GuillemCabo/badge_drac/hardware/kicad/drac_badge.kicad_pcb

## KiCad design hardware/kicad/drac_badge.kicad_pcb (2019-09-20)

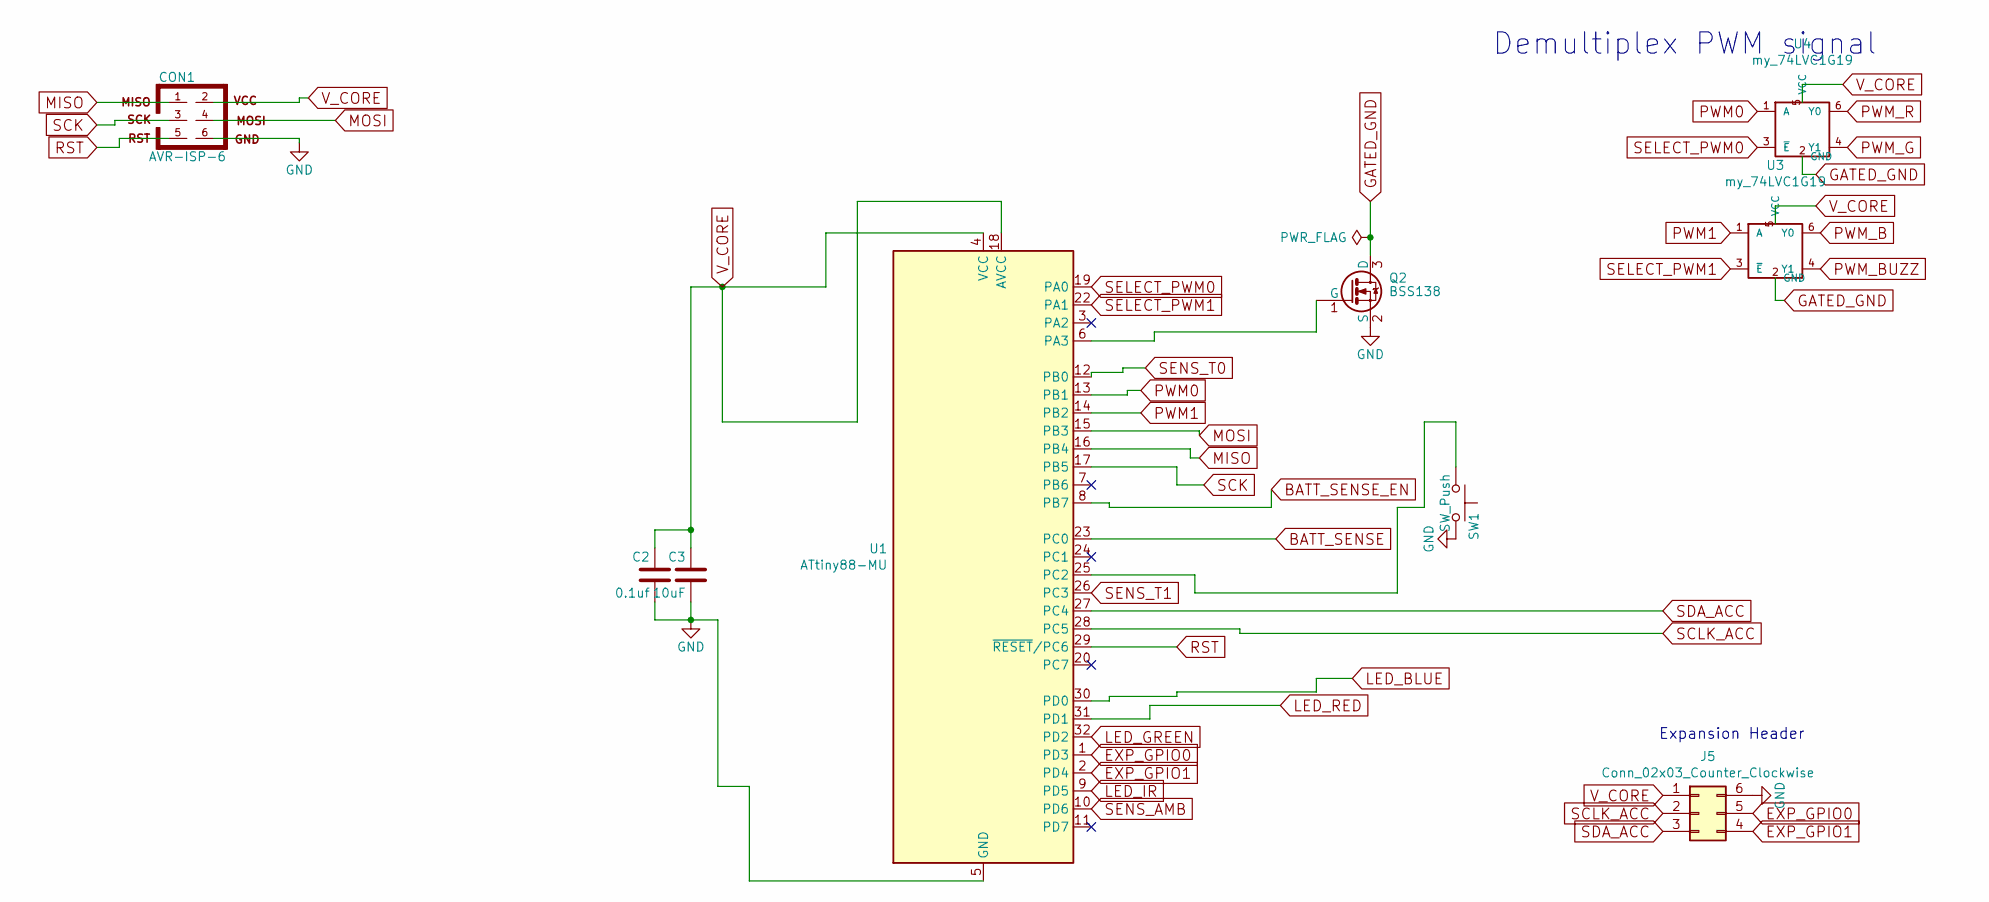
[picture p1: schematic MCU_ATTINY88.sch, keysafe]

Parts:
C2: 0.1uf; C_0603_1608Metric; MPN C0603C104J5RACTU; FARNELL # 2409037
C3: 10uF; C_0805_2012Metric; MPN C0805X106K9RACTU; FARNELL # 2776900
CON1: AVR-ISP-6; MERGED_TAGCONNECT_2.54mm; MPN NONE; FARNELL # NONE
J5: Conn_02x03_Counter_Clockwise; PinSocket_2x03_P2.54mm_Vertical_SMD
Q2: BSS138; SOT-23; MPN BSS138PW; FARNELL # 1907611
SW1: SW_Push; SW_Push_1P1T_NO_CK_KSC7xxJ; MPN EVQPUK02K; FARNELL # 2079467
U1: ATtiny88-MU; QFN-32-1EP_5x5mm_P0.5mm_EP3.1x3.1mm; MPN ATTINY88-MU; FARNELL # 1748549
U3, U4: my_74LVC1G19; SOT-363_SC-70-6

Connections:
BATT_SENSE: U1.23 (PC0); also elsewhere on the board
BATT_SENSE_EN: U1.8 (PB7); also elsewhere on the board
EXP_GPIO0: J5.5, U1.1 (PD3)
EXP_GPIO1: J5.4, U1.2 (PD4)
GATED_GND: Q2.3 (D), U3.2 (GND), U4.2 (GND); also elsewhere on the board
GND: C2.2, C3.2, CON1.6, J5.6, Q2.2 (S), SW1.2, U1.5 (GND), U1.21 (GND), U1.33 (GND); also elsewhere on the board
LED_BLUE: U1.30 (PD0); also elsewhere on the board
LED_GREEN: U1.32 (PD2); also elsewhere on the board
LED_IR: U1.9 (PD5); also elsewhere on the board
LED_RED: U1.31 (PD1); also elsewhere on the board
MISO: CON1.1, U1.16 (PB4)
MOSI: CON1.4, U1.15 (PB3)
unnamed: Q2.1 (G), U1.6 (PA3)
unnamed: SW1.1, U1.25 (PC2)
PWM0: U1.13 (PB1), U4.1 (A)
PWM1: U1.14 (PB2), U3.1 (A)
PWM_B: U3.6 (Y0); also elsewhere on the board
PWM_BUZZ: U3.4 (Y1); also elsewhere on the board
PWM_G: U4.4 (Y1); also elsewhere on the board
PWM_R: U4.6 (Y0); also elsewhere on the board
RST: CON1.5, U1.29 (~RESET~/PC6)
SCK: CON1.3, U1.17 (PB5)
SCLK_ACC: J5.2, U1.28 (PC5)
SDA_ACC: J5.3, U1.27 (PC4)
SELECT_PWM0: U1.19 (PA0), U4.3 (~E)
SELECT_PWM1: U1.22 (PA1), U3.3 (~E)
SENS_AMB: U1.10 (PD6); also elsewhere on the board
SENS_T0: U1.12 (PB0); also elsewhere on the board
SENS_T1: U1.26 (PC3); also elsewhere on the board
V_CORE: C2.1, C3.1, CON1.2, J5.1, U1.4 (VCC), U1.18 (AVCC), U3.5 (VCC), U4.5 (VCC); also elsewhere on the board

Notes on the sheet:
Demultiplex PWM signal
Expansion Header

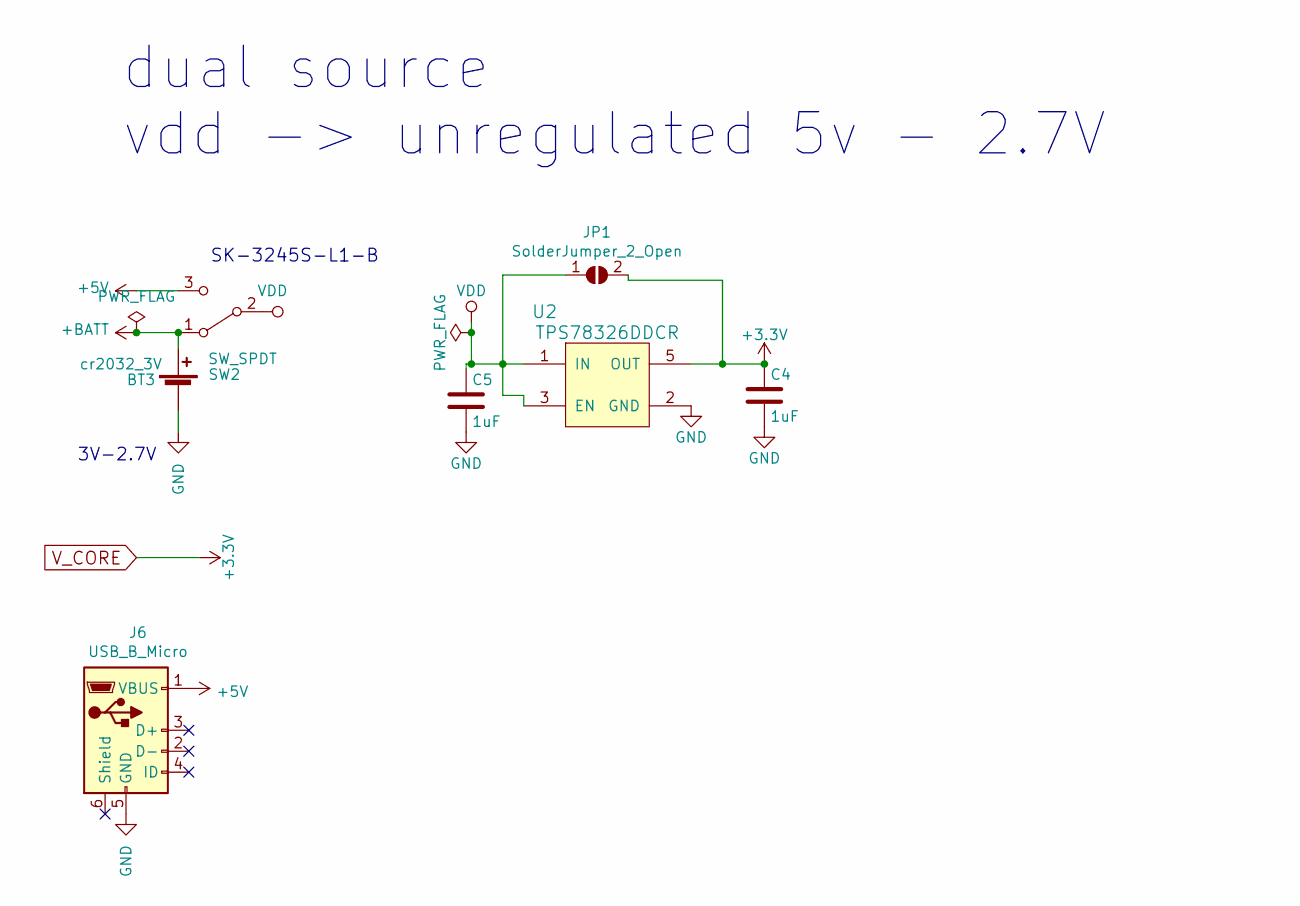
[picture p2: schematic power.sch, keysafe]

Parts:
BT3: cr2032_3V; BatteryHolder_Keystone_1060_1x2032; MPN NONE; FARNELL # NONE
C4, C5: 1uF; C_0603_1608Metric; MPN C0603C105K9RACTU; FARNELL # 1865556
J6: USB_B_Micro; microusb_C40945
JP1: SolderJumper_2_Open; SolderJumper-2_P1.3mm_Open_TrianglePad1.0x1.5mm
SW2: SW_SPDT; toogle_sw_K3-2235S-F1
U2: TPS78326DDCR; SOT-23-5; MPN TPS78326DDCR; FARNELL # 2307970

Connections:
+5V: J6.1 (VBUS), SW2.3 (C)
+BATT: BT3.1 (+), SW2.1 (A)
GND: BT3.2 (-), C4.2, C5.2, J6.5 (GND), U2.2 (GND); also elsewhere on the board
VDD: C5.1, JP1.1 (A), SW2.2 (B), U2.1 (IN), U2.3 (EN); also elsewhere on the board
V_CORE: C4.1, JP1.2 (B), U2.5 (OUT); also elsewhere on the board

Notes on the sheet:
3V-2.7V
dual source vdd -> unregulated 5v - 2.7V
SK-3245S-L1-B

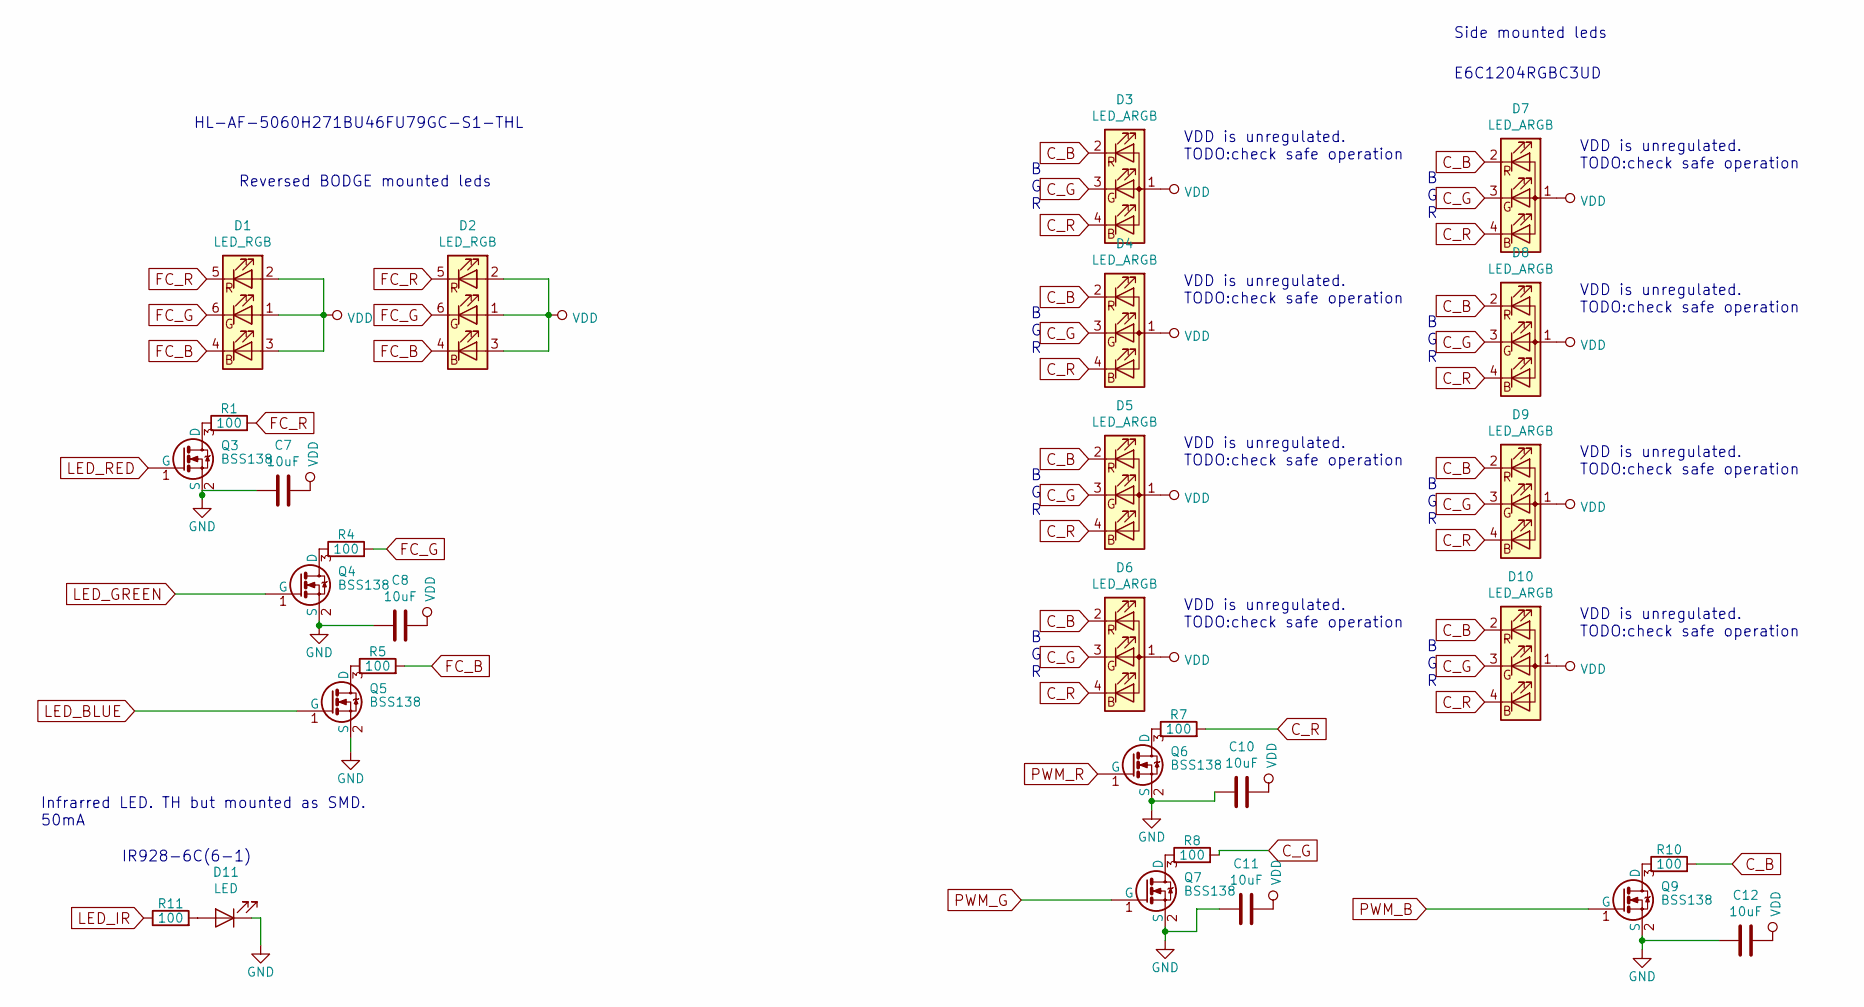
[picture p3: schematic LEDS.sch, keysafe]

Parts:
C7, C8, C10, C11, C12: 10uF; C_0805_2012Metric
D1, D2: LED_RGB; LED_RGB_5050-6
D3, D4, D5, D6, D7, D8, D9, D10: LED_ARGB; E6C1204RGBC3
D11: LED; 01x02_wire_solder_smd
Q3, Q4, Q5, Q6, Q7, Q9: BSS138; SOT-23; MPN BSS138PW; FARNELL # 1907611
R1, R4, R5, R7, R8, R10: 100; R_0603_1608Metric; FARNELL # 1469752
R11: 100; R_0805_2012Metric; FARNELL # 1469752

Connections:
C_B: D3.2 (RK), D4.2 (RK), D5.2 (RK), D6.2 (RK), D7.2 (RK), D8.2 (RK), D9.2 (RK), D10.2 (RK), R10.2
C_G: D3.3 (GK), D4.3 (GK), D5.3 (GK), D6.3 (GK), D7.3 (GK), D8.3 (GK), D9.3 (GK), D10.3 (GK), R8.2
C_R: D3.4 (BK), D4.4 (BK), D5.4 (BK), D6.4 (BK), D7.4 (BK), D8.4 (BK), D9.4 (BK), D10.4 (BK), R7.2
FC_B: D1.4 (BK), D2.4 (BK), R5.2
FC_G: D1.6 (GK), D2.6 (GK), R4.2
FC_R: D1.5 (RK), D2.5 (RK), R1.2
GND: C7.2, C8.1, C10.2, C11.2, C12.2, D11.1 (K), Q3.2 (S), Q4.2 (S), Q5.2 (S), Q6.2 (S), Q7.2 (S), Q9.2 (S); also elsewhere on the board
LED_BLUE: Q5.1 (G); also elsewhere on the board
LED_GREEN: Q4.1 (G); also elsewhere on the board
LED_IR: R11.1; also elsewhere on the board
LED_RED: Q3.1 (G); also elsewhere on the board
unnamed: D11.2 (A), R11.2
unnamed: Q3.3 (D), R1.1
unnamed: Q4.3 (D), R4.1
unnamed: Q5.3 (D), R5.1
unnamed: Q6.3 (D), R7.1
unnamed: Q7.3 (D), R8.1
unnamed: Q9.3 (D), R10.1
PWM_B: Q9.1 (G); also elsewhere on the board
PWM_G: Q7.1 (G); also elsewhere on the board
PWM_R: Q6.1 (G); also elsewhere on the board
VDD: C7.1, C8.2, C10.1, C11.1, C12.1, D1.1 (GA), D1.2 (RA), D1.3 (BA), D2.1 (GA), D2.2 (RA), D2.3 (BA), D3.1 (A), D4.1 (A), D5.1 (A), D6.1 (A), D7.1 (A), D8.1 (A), D9.1 (A), D10.1 (A); also elsewhere on the board

Notes on the sheet:
B G R
VDD is unregulated. TODO:check safe operation
E6C1204RGBC3UD
Reversed BODGE mounted leds
Side mounted leds
HL-AF-5060H271BU46FU79GC-S1-THL
IR928-6C(6-1)
Infrarred LED. TH but mounted as SMD. 50mA

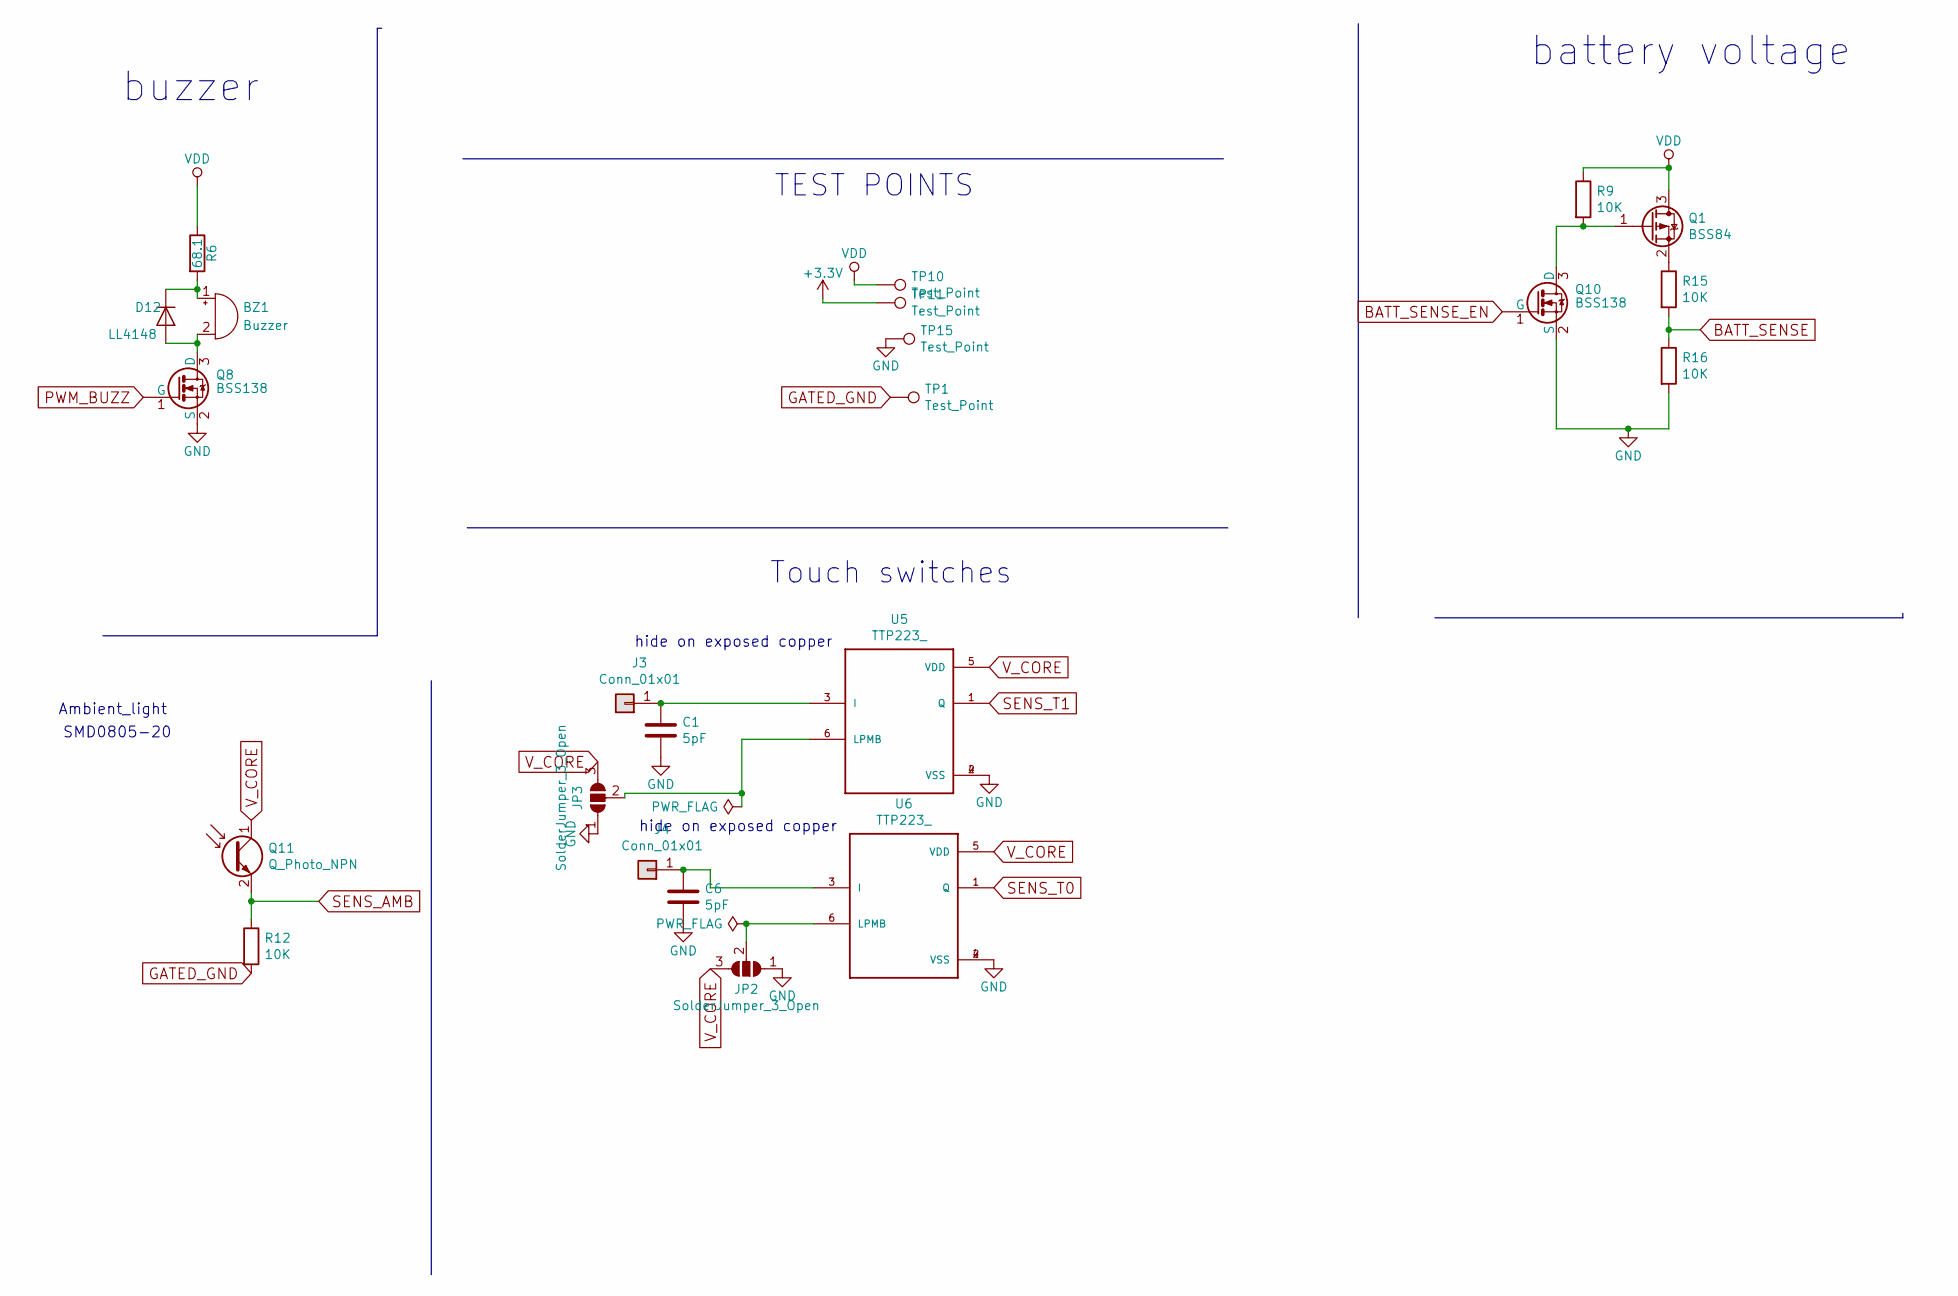
[picture p4: schematic BUZZ_AND_SENS.sch, keysafe]

Parts:
BZ1: Buzzer; MLT-9032; MPN NONE; FARNELL # NONE
C1, C6: 5pF; C_0603_1608Metric
D12: LL4148; D_MiniMELF
J3, J4: Conn_01x01; testpoint_small
JP2, JP3: SolderJumper_3_Open; SolderJumper-3_P1.3mm_Bridged2Bar12_Pad1.0x1.5mm_NumberLabe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
Q1: BSS84; SOT-23; MPN BSS84,215; FARNELL # 1510765
Q8, Q10: BSS138; SOT-23; MPN BSS138PW; FARNELL # 1907611
Q11: Q_Photo_NPN; LED_0805_2012Metric_Pad1.15x1.40mm_HandSolder
R6: 68.1; R_1206_3216Metric; MPN MCWR06X68R1FTL; FARNELL # 2694929
R9, R12, R15, R16: 10K; R_0603_1608Metric; MPN CRGH0603F10K; FARNELL # 2332016
TP1, TP15: Test_Point; TestPoint_Pad_2.5x2.5mm; MPN NONE; FARNELL # NONE
TP10, TP11: Test_Point; TestPoint_Pad_D2.5mm; MPN NONE; FARNELL # NONE
U5, U6: TTP223_; SOT95P285X126-6N

Connections:
BATT_SENSE: R15.2, R16.1; also elsewhere on the board
BATT_SENSE_EN: Q10.1 (G); also elsewhere on the board
GATED_GND: R12.2, TP1.1; also elsewhere on the board
GND: C1.2, C6.2, JP2.1 (A), JP3.1 (A), Q8.2 (S), Q10.2 (S), R16.2, TP15.1, U5.2 (VSS), U5.4 (VSS), U6.2 (VSS), U6.4 (VSS); also elsewhere on the board
unnamed: BZ1.1 (-), D12.1 (K), R6.2
unnamed: BZ1.2 (+), D12.2 (A), Q8.3 (D)
unnamed: C1.1, J3.1, U5.3 (I)
unnamed: C6.1, J4.1, U6.3 (I)
unnamed: JP2.2 (C), U6.6 (LPMB)
unnamed: JP3.2 (C), U5.6 (LPMB)
unnamed: Q1.1 (G), Q10.3 (D), R9.2
unnamed: Q1.2 (S), R15.1
PWM_BUZZ: Q8.1 (G); also elsewhere on the board
SENS_AMB: Q11.2 (E), R12.1; also elsewhere on the board
SENS_T0: U6.1 (Q); also elsewhere on the board
SENS_T1: U5.1 (Q); also elsewhere on the board
VDD: Q1.3 (D), R6.1, R9.1, TP10.1; also elsewhere on the board
V_CORE: JP2.3 (B), JP3.3 (B), Q11.1 (C), TP11.1, U5.5 (VDD), U6.5 (VDD); also elsewhere on the board

Notes on the sheet:
buzzer
battery voltage
TEST POINTS
Ambient_light
SMD0805-20
hide on exposed copper
Touch switches

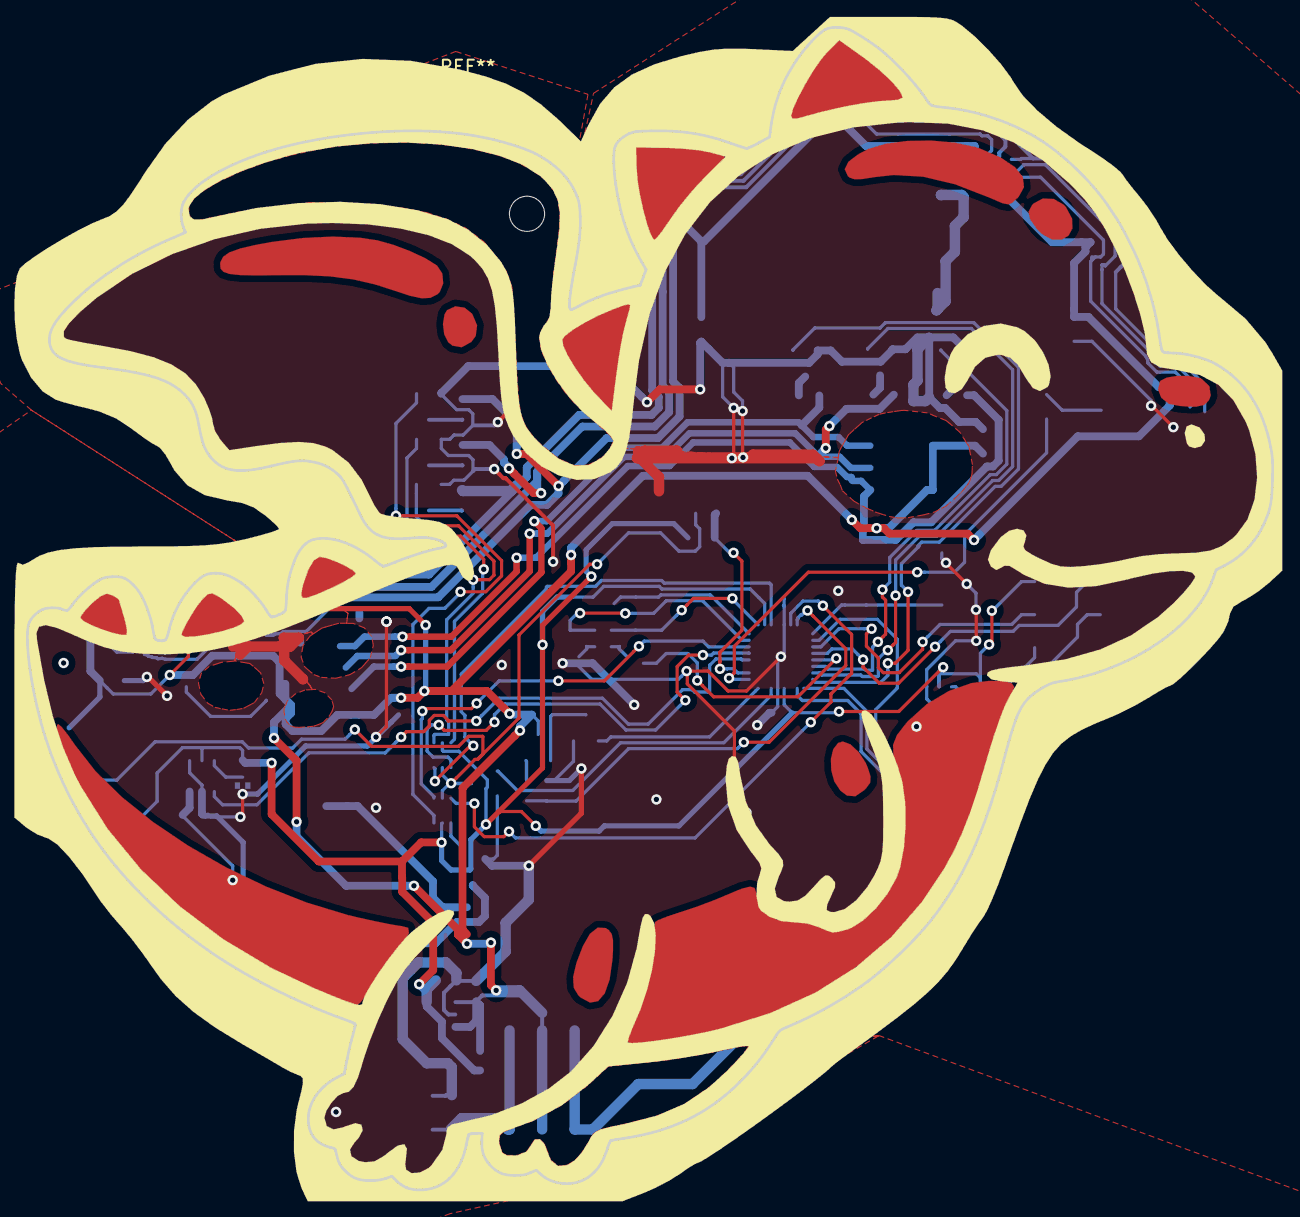
[picture p5: board drac_badge.kicad_pcb from above]

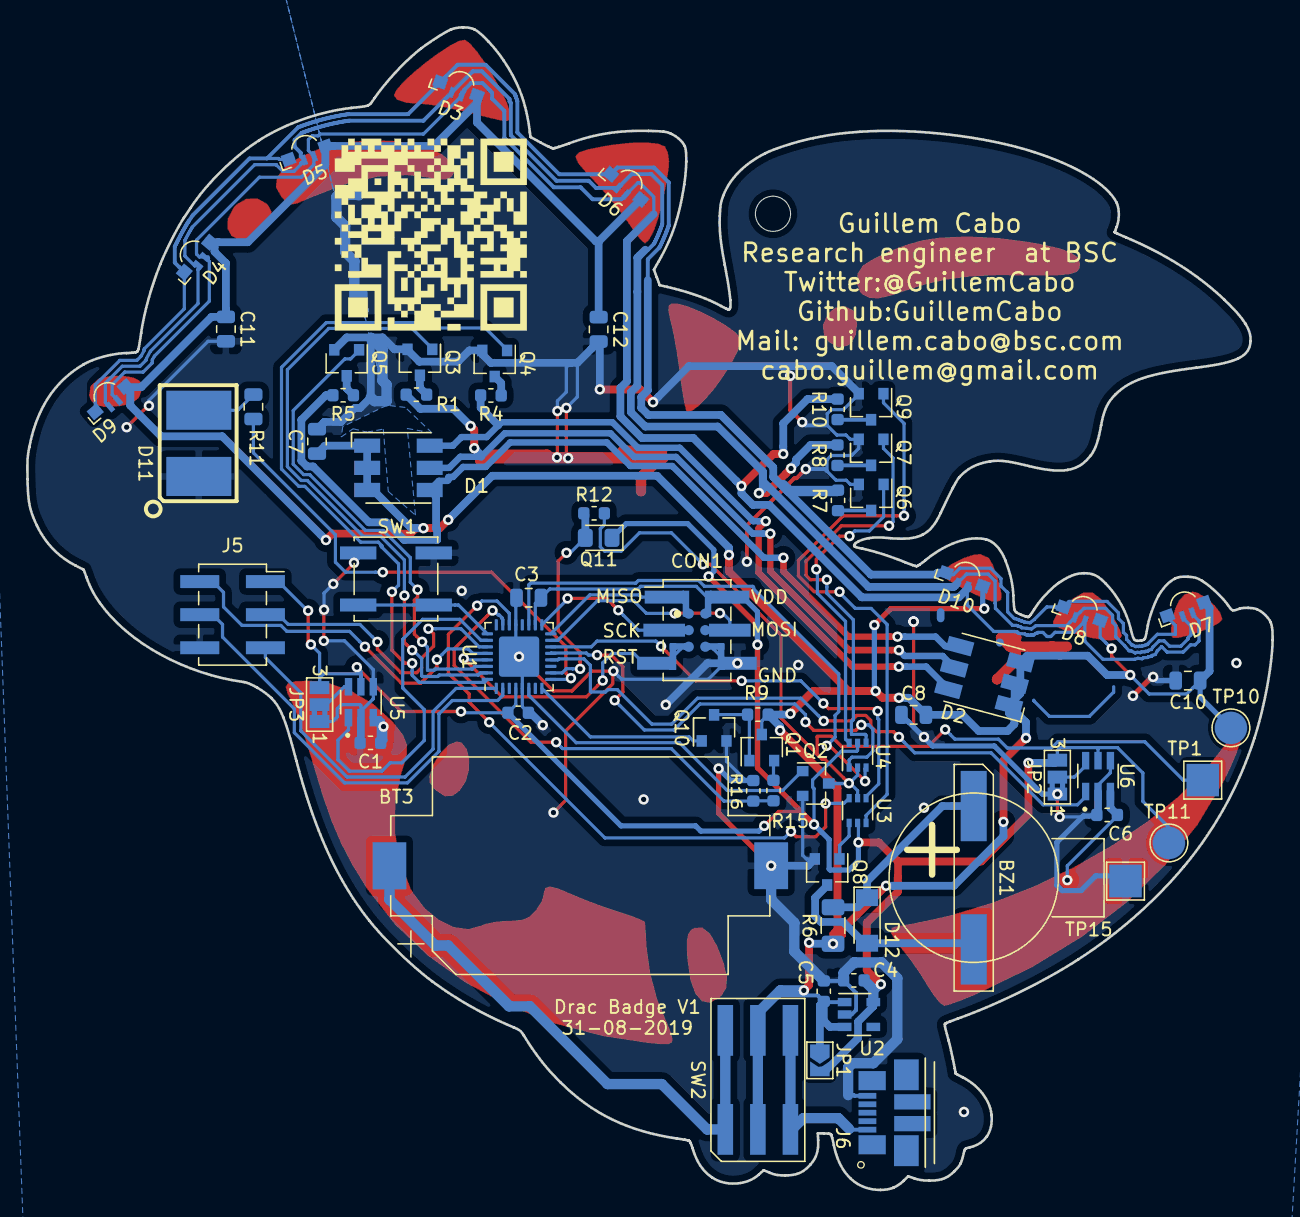
[picture p6: board drac_badge.kicad_pcb from below]

Board: 2 copper layers, 95.6 x 89.2 mm, 68 parts (66 on the bottom side), 54 nets.
