GuillemCabo/badge_drac/(commit log)

2019-09-19 Quick sample program
2019-09-20 ugly kicad project
    [BUZZ_AND_SENS.sch, LDO_3XAAA.sch, LEDS.sch, MCU_ATTINY88.sch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]
2019-09-21 added pin map
2019-09-22 pin map for badge rev1 with jumper wires and example code
    Blink all LEDs, Buzzer tone, ambient light read
    [buzzer.cpp, buzzer.h, main.ino, pin_map.h, sensors.cpp, sensors.h]
